jimbr99/Tx_Rev3a/BOM/Tx_Ver3a.xlsx

Designator | Qty. | Part | Description | Mount | Package | Mfr. | Mfr. Part No. | Distributor | Dist. Part No. | Notes
C12 | 1 | 220uF/50V/ATLLSeries | AL-Elko ATLL-Series | THT | 10mm x 16mm | Würth Elektronik eiSos | 860010675018 | Mouser | 710-860010675018
C1, C9, C17,C50 | 4 | 22uF | 50V | THT |  | Vishay / BC Components | MAL211671229E3 | Mouser | 594-MAL211671229E3
C2, C13, C16 | 3 | 47uF | 50V | THT |  | Würth Elektronik eiSos | 860020673013 | Mouser | 710-860020673013
C3, C8, C10, C11, C14, C18, C51 | 7 | 0.1uF | XR7 50V | SMD | 0603 | Kyocera AVX | 06035C104MAT2A | Mouser | 581-06035C104MAT2A
C4, C5, C6 | 3 | 33nF/250V | MLCC - SMD/SMT | SMD | 1210 | TDK | C3225NP02E333J230AA | DigiKey | 445-172551-1-ND | Use C6 with Onda 3D Coil
C6 | 1 | 250V 6800pF C0G | MLCC - SMD/SMT | SMD | 1210 | KEMET | C1206C682JAGACAUTO | Mouser | 80-C1206C682JAGAUTO | Use C6 with PC Coil
C52 | 1 | 1000uF/35V/ATLL-Series | AL-Elko ATLL-Series | THT | 13mm x 35mm | Würth Elektronik eiSos | 860160578032 | Mouser | 710-860160578032
D1, D2, D3, D4, D5, D6 | 6 | 1N4148W | DIODE GEN PURP 100V 300MA SOD123 | SMD | DO-123 | Diodes Incorporated | 1N4148W-13-F | DigiKey | 1N4148W-13FDICT-ND | Use for D3, D6 as well.
D7 | 1 | 150080BS75000 | Standard LEDs - SMD WL-SMCW SMDMono TpVw Waterclr 0805 Blue | SMD/SMT | 0805 (2012 metric) | Wurth Elektronik | 150080BS75000 | Mouser | 710-150080BS75000
D8 | 1 | 150080GS75000 | Standard LEDs - SMD WL-SMCW SMDMono TpVw Waterclr 0805 Green | SMD/SMT | 0805 (2012 metric) | Wurth Elektronik | 150080GS75000 | Mouser | 710-150080GS75000
R1, R2, R3, R4 | 4 | 10R0 /0.25W | Thick Film Resistor | SMD | 0802 |  | RCC080510R0FKEA | Mouser | 71-RCC080510R0FKEA
R5, R6, R7, R8, R9 | 5 | SMD 1K 1% | Thick Film Resistor | SMD | 0805 | Bourns | CR0805-FX-1001ELF | Mouser | 652-CR0805FX-1001ELF
R10 | 1 | SMD 0-Ohm | Thick Film Resistors 0 Ohms 0805 5% | SMD | 0805 | YAGEO | RC0805JR-130RL | Mouser | 603-RC0805JR-130RL
R12 | 4 | SMD 4.7k | Thick Film Resistor | SMD | 0805 | Vishay | CRCW08054K70JNEA (https://www.mouser.com/ProductDetail/Vishay-Dale/CRCW08054K70JNEA?qs=kkyyugUlSrPc3tCn%2F8R5yw%3D%3D) | Mouser | 71-CRCW0805J-4.7K-E3 (https://www.mouser.com/ProductDetail/Vishay-Dale/CRCW08054K70JNEA?qs=kkyyugUlSrPc3tCn%2F8R5yw%3D%3D)
R13 | 1 | SMD 20K 5% | Thick Film Resistor | SMD | 0805 | Panasonic | ERJ-6GEYJ203V | Digikey | P20KACT-ND
L1 | 1 | 33uH | Fixed Inductors 33uH Shld 20% 3.1A 68.8mOhms AECQ2 | Axial | Axial | Coilcraft | MSS1278-333MLD | Mouser | 994-MSS1278-333MLD
U1, U3 | 2 | IR2110 | DIP-14 | THT | DIP-14 | IR | IR2110PBF | DigiKey | IR2110PBF-ND
U2 | 1 | 74HC04 |  | THT | DIP-14 | TI | SN74HC04N | Mouser | 595-SN74HC04N
U4 | 1 | DS1077Z-100+ | IC OSC DUAL FX FREQ PROG 8SOIC | SMT | 8-SOIC | Analog Devices | DS1077Z-100+; Mouser: 700-DS1077Z-100 | DigiKey or Mouser | Digikey: DS1077Z-100+-ND; Mouser: 700-DS1077Z-100 | Get from Mouser
U7 | 3 | LM340SX-5.0/NOPB | Linear Voltage Regulator | SMD | TO-220 | TI | LM340SX-5.0/NOPB | TI Ordering | LM340SX-5.0/NOPB
Q1, Q2, Q3, Q4 | 4 | 863-NTBS2D7N06M7 | MOSFET MOSFET NMOS 60V 2.7 MOHM | D2PAK-3 (TO-263) | TO-263 | Vishay Semiconductors (https://www.mouser.com/manufacturer/vishaysemiconductors/) | NTBS2D7N06M7 | Mouser | 863-NTBS2D7N06M7
J2 | 1 | TERM BLK 2P SIDE ENT 5.08MM PCB |  | THT | 0.200" | Phoenix Contact | 1729128 | DigiKey | 277-1247-ND | #1 choice
J3 | 1 | CONN HEADER VERT 3POS 2.54MM |  | THT | 0.100" (2.54mm) | Molex | 22112036 | DigiKey | WM19461-ND
J4 | 1 | DC Power Jack | DC Power Connectors WR-DC PwrJk CtrPnSMT RtAngld W/4 Sldg Pad | THT | Inside: 2.5 mm, Outside: 6.4 mm | Wurth Elektronik | 694108106102 | Mouser | 710-694108106102
J5 | 1 | SIP HEADER VERT 1 x 3 | SIP Header pins only | THT | 0.100" |  | ZYAMY 10pcs 2.54mm Male Breakable Pin Header Strip 40Pin 1x40P Single Row Straight Gold Plated Male Pin Header Strip | Amazon
S1 | 1 | SPST On/Off |  |  |  |  | L-PBS-110-XR | Amazon | Twidec/4Pcs Latching Push Button Switch | Not specified
F1 | 1 | Fuse | 5.0A Slow Blow 1206 SinglFuse | SMD | 1206 | Bourns | SF-1206S500W-2 | Mouser | 652-SF-1206S500W-2 | Use 5A or 3A Slow Blow
Note: there is no R11.
Updated BOM with corrected part numbers following assembly build.
