jimbr99/Tx_Rev3a/TxRev3a-sch.pdf

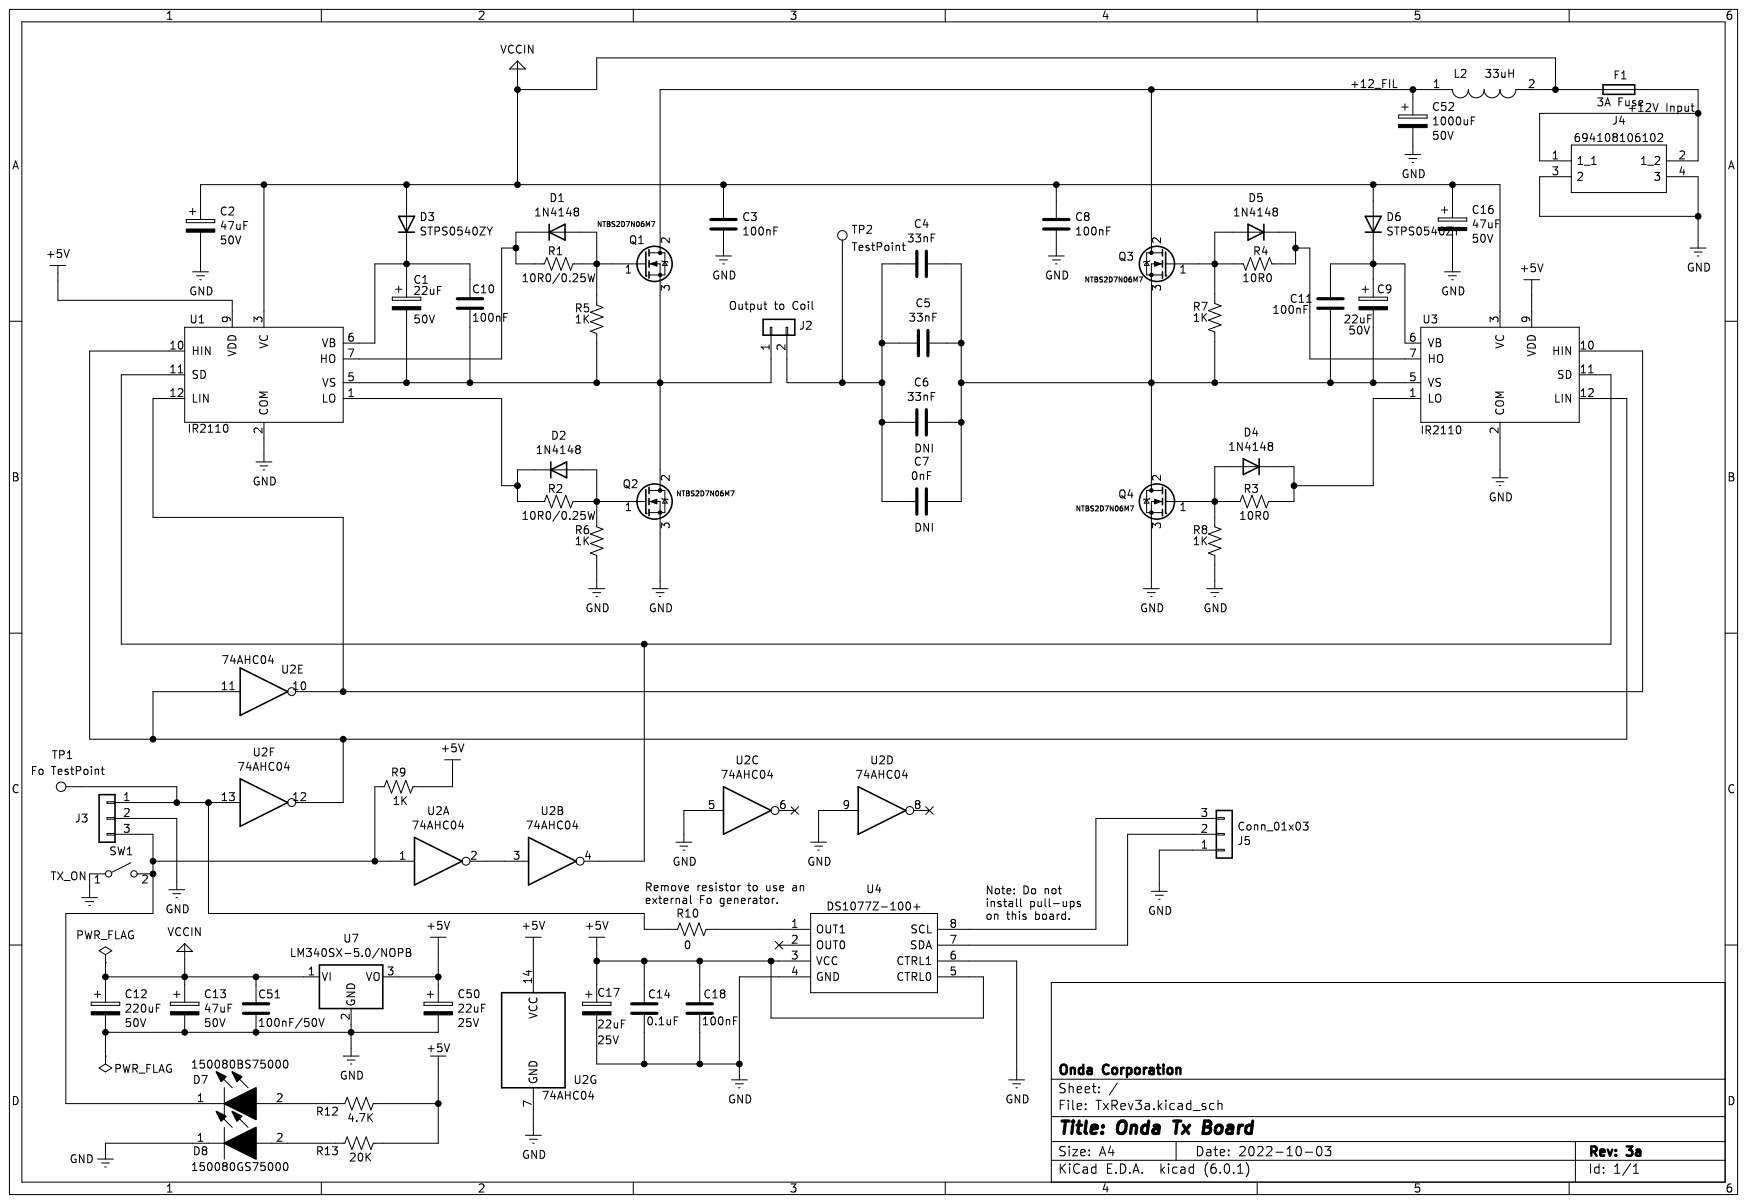
[picture p1: page 1]
