jimbr99/Tx_Rev3a/TxRev3a.kicad_pcb

## KiCad design TxRev3a.kicad_pcb (2022-11-07)

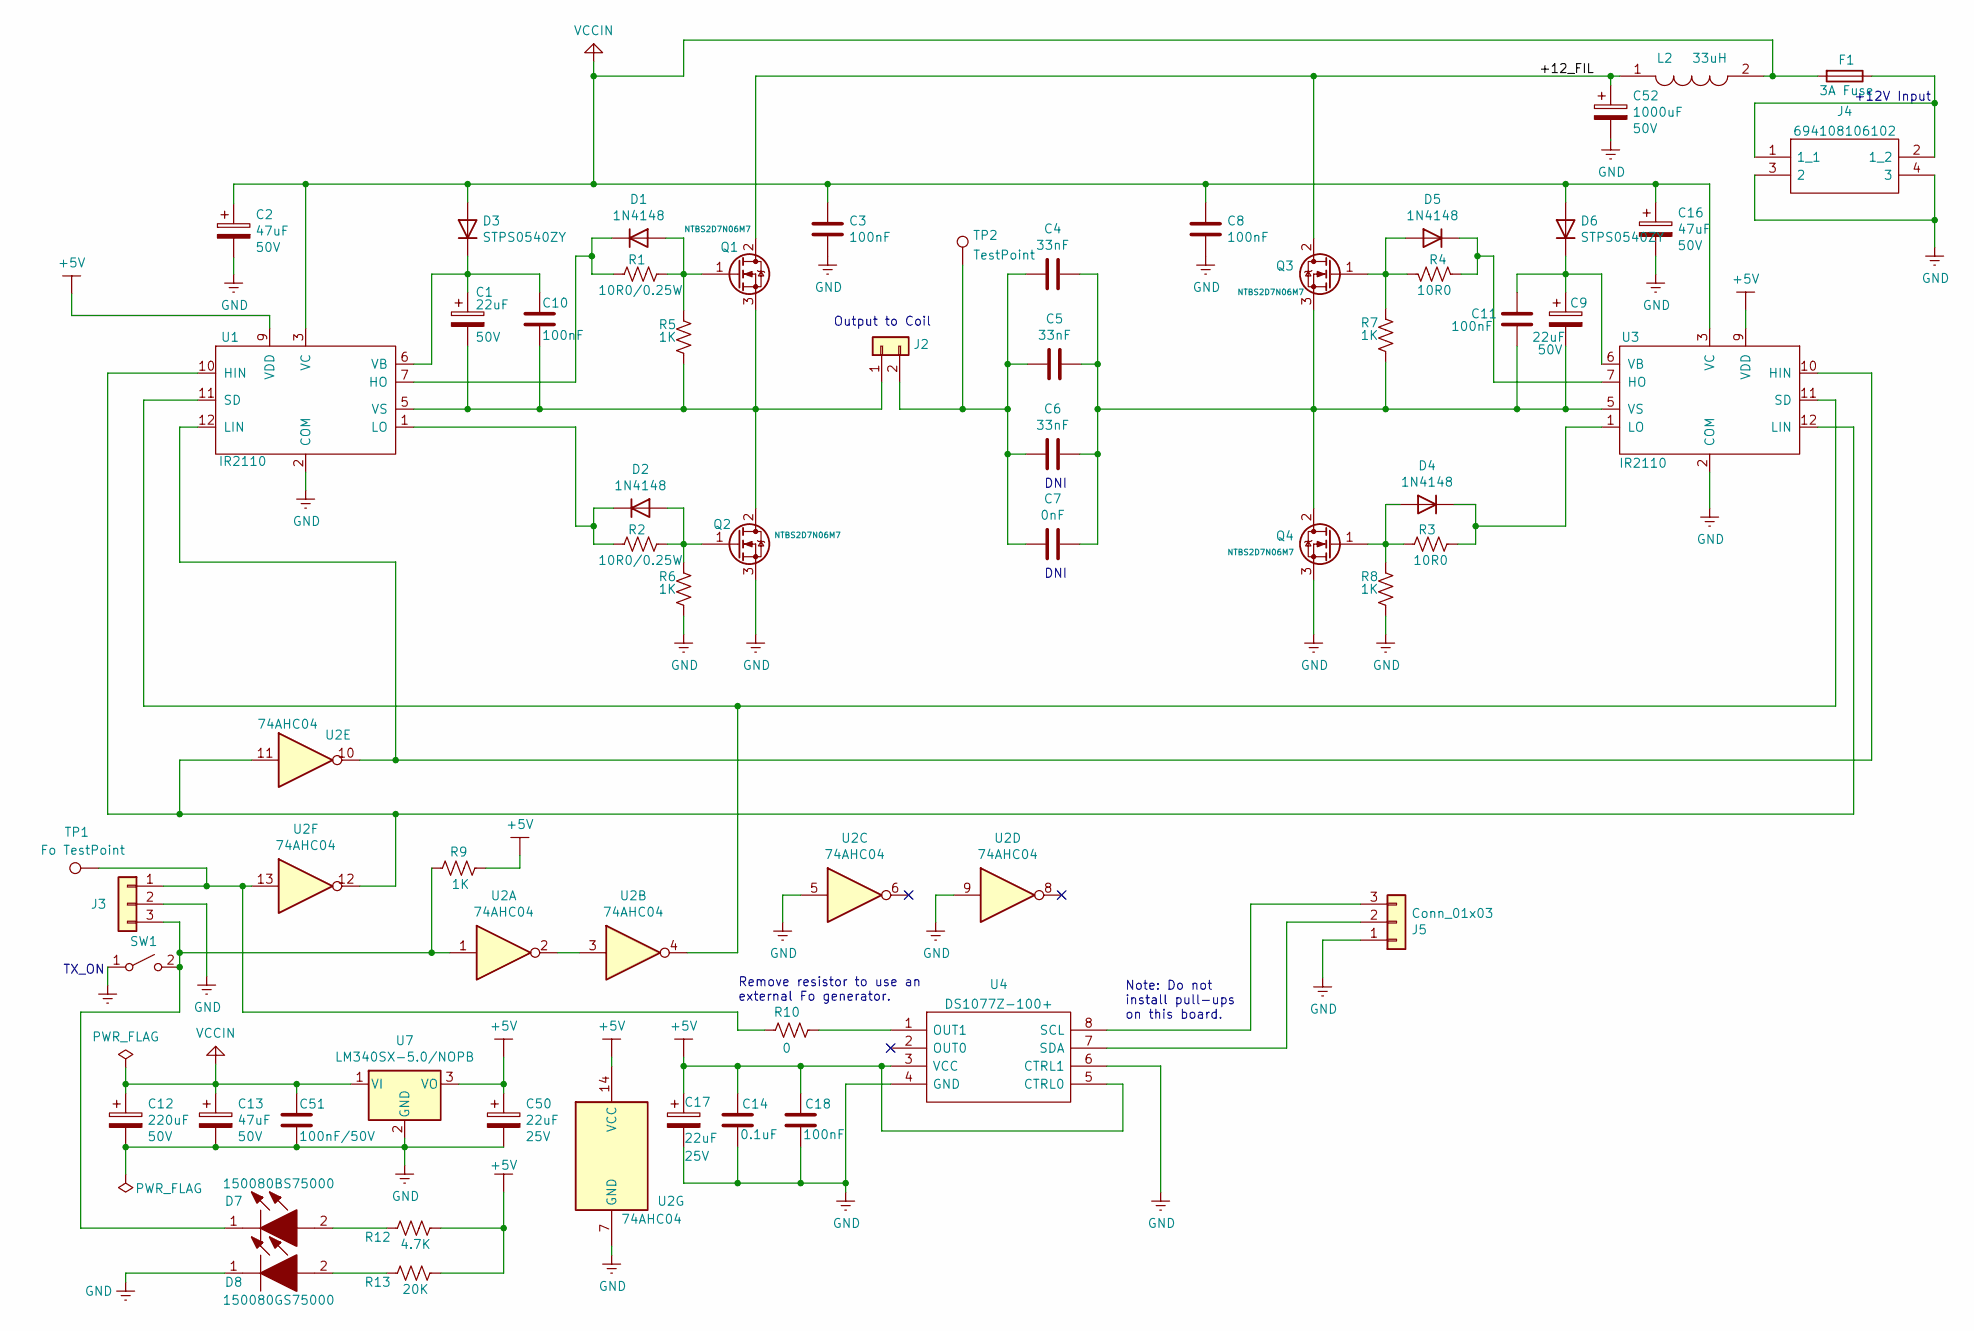
[picture p2: schematic TxRev3a.kicad_sch, Onda Tx Board]

Parts:
C1, C9: 22uF; CP_Radial_D5.0mm_P2.50mm; Voltage 50V
C2, C13, C16: 47uF; CP_Radial_D6.3mm_P2.50mm; Voltage 50V
C3, C8, C10, C11, C18: 100nF; C_0603_1608Metric_Pad1.08x0.95mm_HandSolder
C4, C5, C6: 33nF; C_1210_3225Metric
C7: 0nF; C_1210_3225Metric
C12: 220uF; CP_Radial_D10.0mm_P5.00mm; Voltage 50V
C14: 0.1uF; C_0402_1005Metric
C17, C50: 22uF; CP_Radial_D5.0mm_P2.50mm; Voltage 25V
C51: 100nF/50V; C_0603_1608Metric_Pad1.08x0.95mm_HandSolder
C52: 1000uF; CP_Radial_D13.0mm_P5.00mm; Voltage 50V
D1, D2, D4, D5: 1N4148; D_DO-35_SOD27_P7.62mm_Horizontal
D3, D6: STPS0540ZY; D_DO-41_SOD81_P10.16mm_Horizontal
D7: 150080BS75000; LEDM2012X80N; Mouser Part Number 710-150080GS75000
D8: 150080GS75000; LEDM2012X80N; Mouser Part Number 710-150080GS75000
F1: 3A Fuse; Fuse_1206_3216Metric
J2: Conn_01x02; PhoenixContact_MCV_1,5_2-G-5.08_1x02_P5.08mm_Vertical
J3, J5: Conn_01x03; Molex_KK-254_AE-6410-03A_1x03_P2.54mm_Vertical
J4: 694108106102; Mouser Part Number 710-694108106102
L2: 33uH; INDPM120120X805N; Mouser Part Number 994-MSS1278-333MLD
Q1, Q2, Q3, Q4: NTBS2D7N06M7; TO-263-2
R1, R2: 10R0/0.25W; R_0805_2012Metric
R3, R4: 10R0; R_0805_2012Metric
R5, R6, R7, R8, R9: 1K; R_0805_2012Metric
R10: 0; R_0805_2012Metric
R12: 4.7K; R_0805_2012Metric
R13: 20K; R_0805_2012Metric
SW1: SW_SPST; Molex_KK-254_AE-6410-02A_1x02_P2.54mm_Vertical
TP1: Fo TestPoint; PinSocket_1x01_P2.54mm_Vertical
TP2: TestPoint
U1, U3: IR2110; DIP-14_W7.62mm
U2: 74AHC04; DIP-14_W7.62mm
U4: DS1077Z-100+; SOIC127P600X175-8N; Mouser Part Number 700-DS1077Z-100
U7: LM340SX-5.0/NOPB; TO-220-3_Vertical

Connections:
+5V: C14.1, C17.1, C18.1, C50.1, R9.1, R12.1, R13.1, U1.9 (VDD), U2.14 (VCC), U3.9 (VDD), U4.3 (VCC), U4.5 (CTRL0), U7.3 (VO)
/+12_FIL: C52.1, L2.1, Q1.2 (D), Q3.2 (D)
GND: C2.2, C3.2, C8.2, C12.2, C13.2, C14.2, C16.2, C17.2, C18.2, C50.2, C51.2, C52.2, D8.1, J3.2, J4.3 (2), J4.4 (3), J5.1, Q2.3 (S), Q4.3 (S), R6.2, R8.2, SW1.1 (A), U1.2 (COM), U2.5, U2.7 (GND), U2.9, U3.2 (COM), U4.4 (GND), U4.6 (CTRL1), U7.2 (GND)
unnamed: C1.1, C10.1, D3.1 (K), U1.6 (VB)
unnamed: C1.2, C10.2, J2.1, Q1.3 (S), Q2.2 (D), R5.2, U1.5 (VS)
unnamed: C4.1, C5.1, C6.1, C7.1, J2.2, TP2.1
unnamed: C9.1, C11.1, D6.1 (K), U3.6 (VB)
unnamed: C4.2, C5.2, C6.2, C7.2, C9.2, C11.2, Q3.3 (S), Q4.2 (D), R7.2, U3.5 (VS)
unnamed: D1.1 (K), R1.1, U1.7 (HO)
unnamed: D1.2 (A), Q1.1 (G), R1.2, R5.1
unnamed: D2.1 (K), R2.1, U1.1 (LO)
unnamed: D2.2 (A), Q2.1 (G), R2.2, R6.1
unnamed: D4.1 (K), R3.2, U3.1 (LO)
unnamed: D4.2 (A), Q4.1 (G), R3.1, R8.1
unnamed: D5.1 (K), R4.1, U3.7 (HO)
unnamed: D5.2 (A), Q3.1 (G), R4.2, R7.1
unnamed: D7.1, J3.3, R9.2, SW1.2 (B), U2.1
unnamed: D7.2, R12.2
unnamed: D8.2, R13.2
unnamed: F1.1, J4.1 (1_1), J4.2 (1_2)
unnamed: J3.1, R10.1, TP1.1, U2.13
unnamed: J5.2, U4.7 (SDA)
unnamed: J5.3, U4.8 (SCL)
unnamed: R10.2, U4.1 (OUT1)
unnamed: U1.10 (HIN), U2.11, U2.12, U3.12 (LIN)
unnamed: U1.11 (SD), U2.4, U3.11 (SD)
unnamed: U1.12 (LIN), U2.10, U3.10 (HIN)
unnamed: U2.2, U2.3
VCCIN: C2.1, C3.1, C8.1, C12.1, C13.1, C16.1, C51.1, D3.2 (A), D6.2 (A), F1.2, L2.2, U1.3 (VC), U3.3 (VC), U7.1 (VI); also elsewhere on the board

Notes on the sheet:
DNI
Output to Coil
TX_ON
Remove resistor to use an external Fo generator.
Note: Do not install pull-ups on this board.
+12V Input

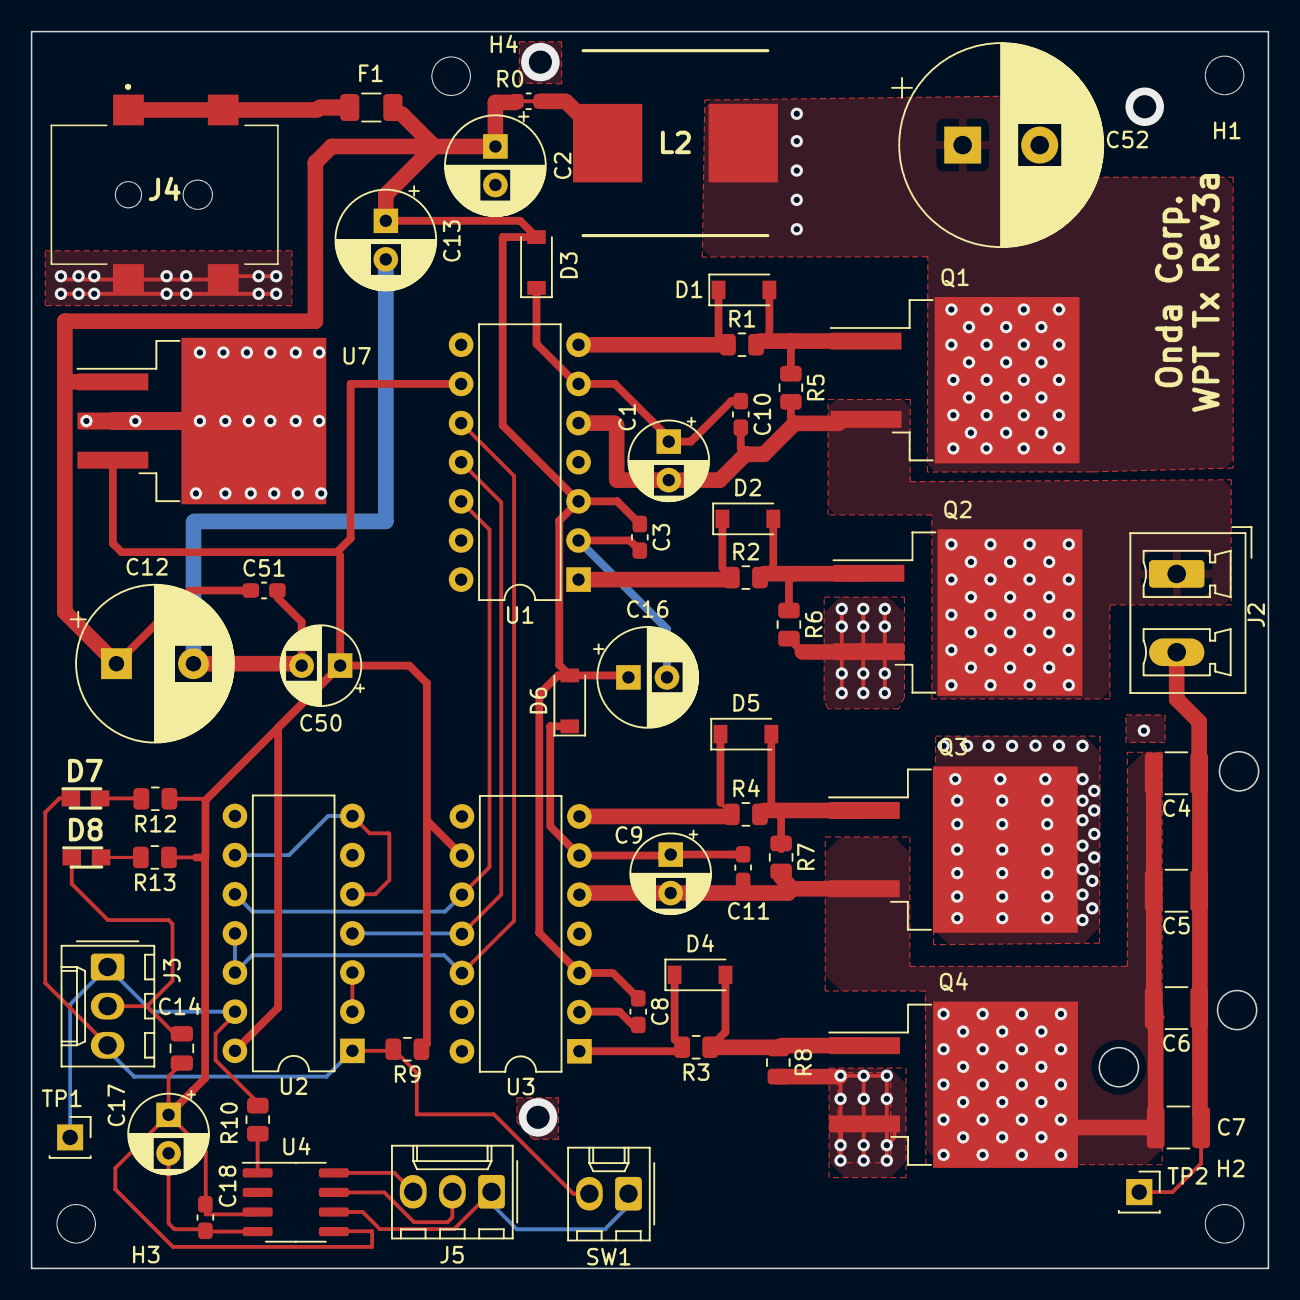
[picture p3: board TxRev3a.kicad_pcb from above]

Board: 4 copper layers, 80.3 x 80.3 mm, 63 parts (0 on the bottom side), 29 nets.

Other parts of the board:
H1, H2, H3, H4: MountingHole_2.5mm
R0: C_0603_1608Metric

Their connections:
VCCIN: R0.1, R0.2; also elsewhere on the board
